b-tima/power_ice/README.md

# power_ice

Project files created for the course II2302 Sensor Based Systems @KTH.

## Project members:

* Morgan Adamsson
* Samuel Svensson
* Skander Ben Messaoud
* Robin Carlet
