b-tima/power_ice/presentation/presentation.pdf

### II2302 project :

# Ice detection sensor

Morgan Adamsson
Robin Carlet
Samuel Svensson
Skander Ben Messaoud

Sensor | What should the sensor detect ?
- Ice
- Water on the surface
- Dry surface

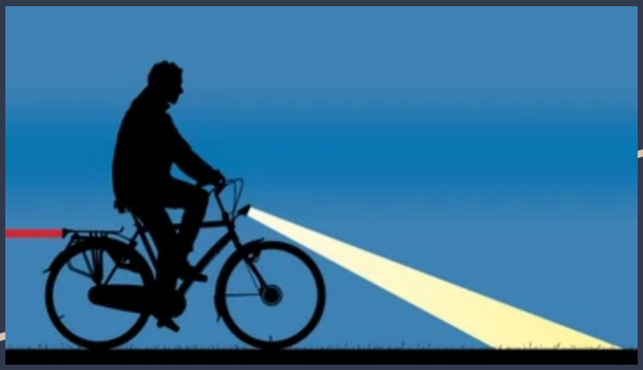
[picture p10: figure]

Applications of the sensor :

- Bicycle accessory
- Ice detection on roads
- Vibrating handles and flashing lights for warning

Implementation | ● Measurement of backscattered

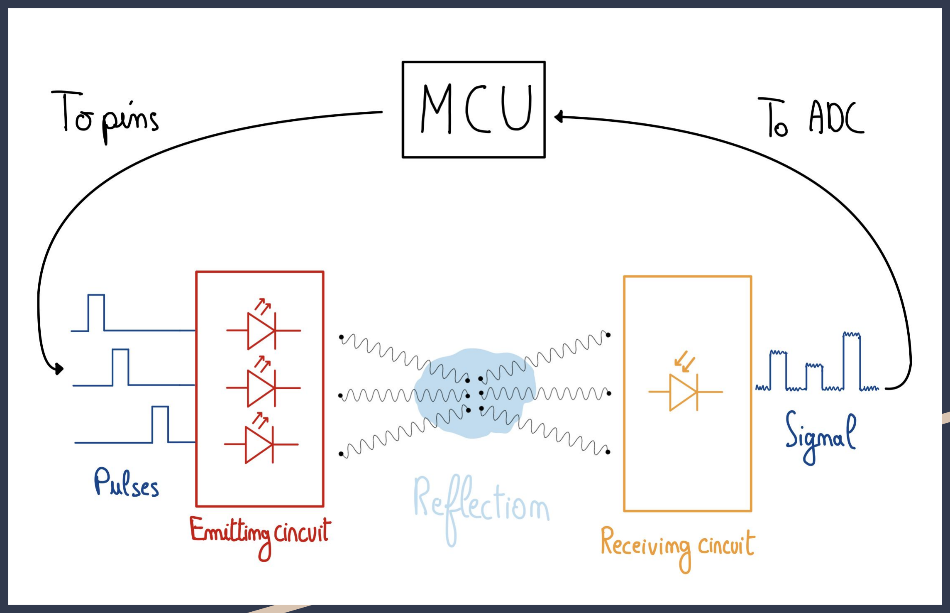
[picture p11: figure]

| power of IR reflections
- Three wavelengths are used
- 1300 nm
- 1450 nm
- 1550 nm
- InGaAs (Indium gallium arsenide) photodiode for detecting
reflections

https://opg.optica.org/view_article.cfm

# Emitting circuit

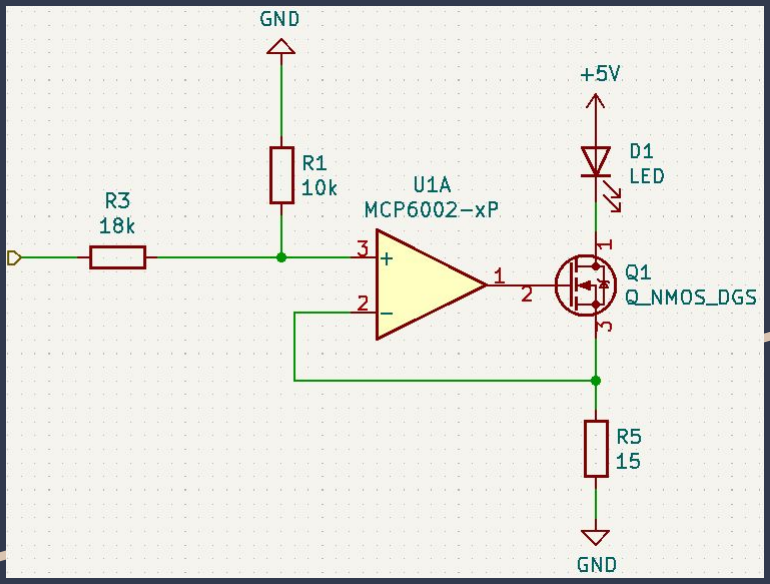
[picture p12: figure]

- Mosfet transistor sinking current from IR LED
- Turns on by voltage from MCU
- Stable and precise current

# Sensing circuit

- Transconductance amplifier to sense the photodiode

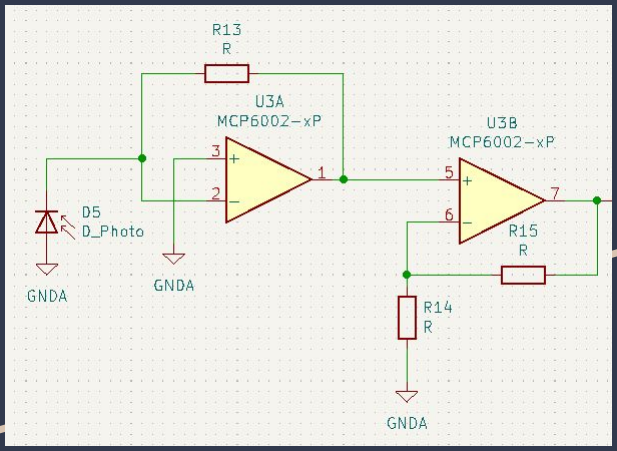
[picture p13: figure]

- Non-Inverting amplifier to increase gain.
- DC-offset is a problem.

Software | ● Pulse LEDs sequentially

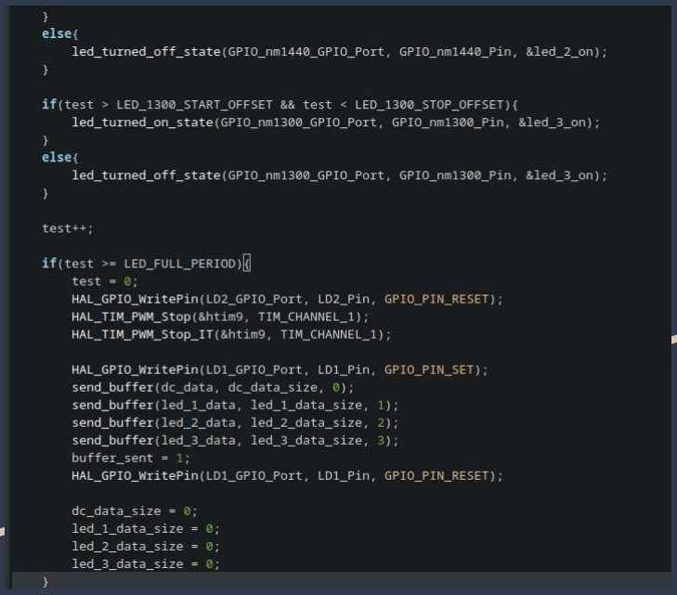
[picture p14: figure]

- Measure reflections with 12-bit ADC
- Store results in array
- Send array to computer at the end of sampling

# Design process

- Constructed circuit on
breadboards

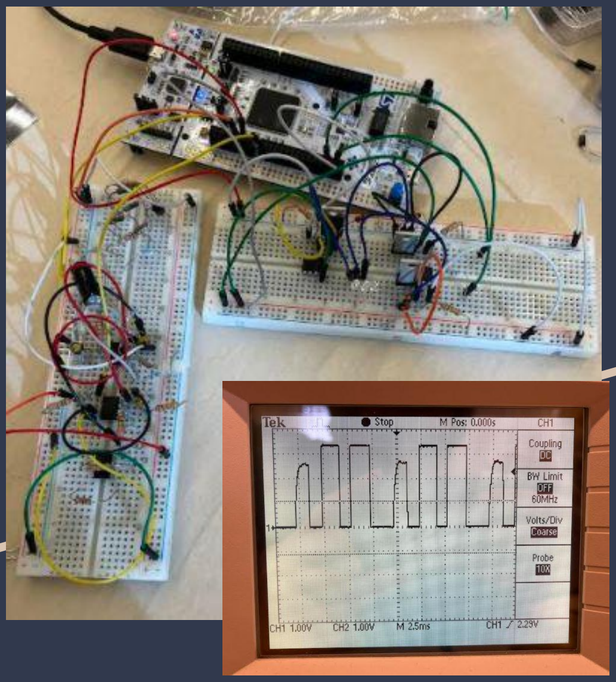
[picture p15: figure]

- LEDs and photodiode on separate boards
- Testing of received signal strength on oscilloscope

- Six LEDs (only three soldered)
- Two cascaded opamps are
unused.
- LEDs surround photodiode

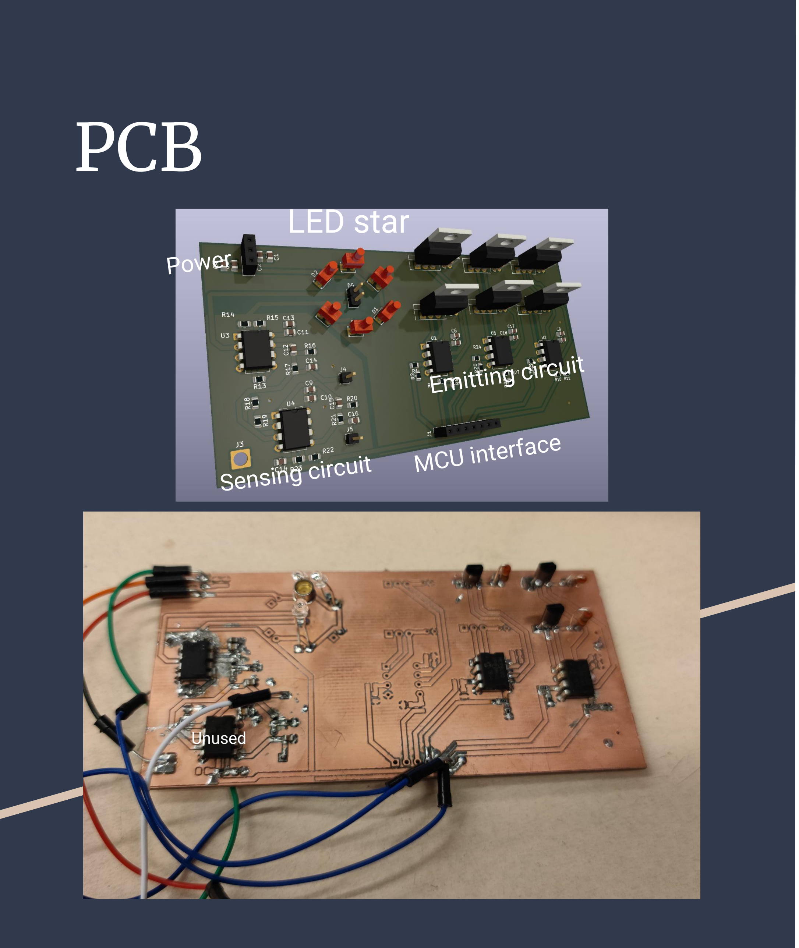
[picture p16: figure]
PCB; Power; Sensing circuit; Emitting circuit; LED star; MCU interface

- Connectors to MCU board Unused

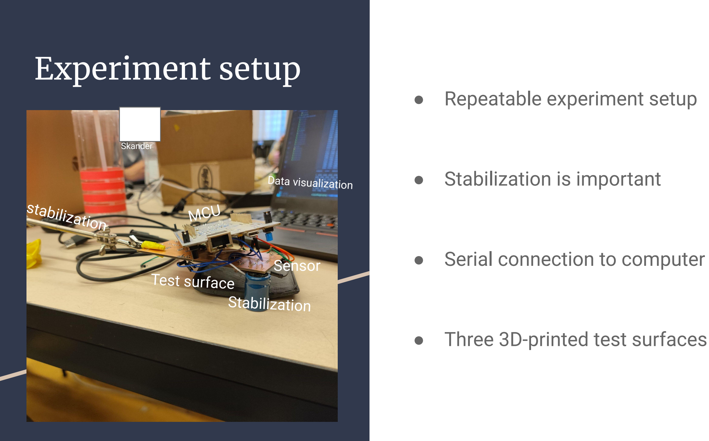
[picture p17: figure]
Experiment setup; ● Repeatable experiment setup; ● Stabilization is important; ● Serial connection to computer; ● Three 3D-printed test surfaces; stabilization; MCU; Sensor; Test surface Stabilization; Data visualization; Skander

# Data

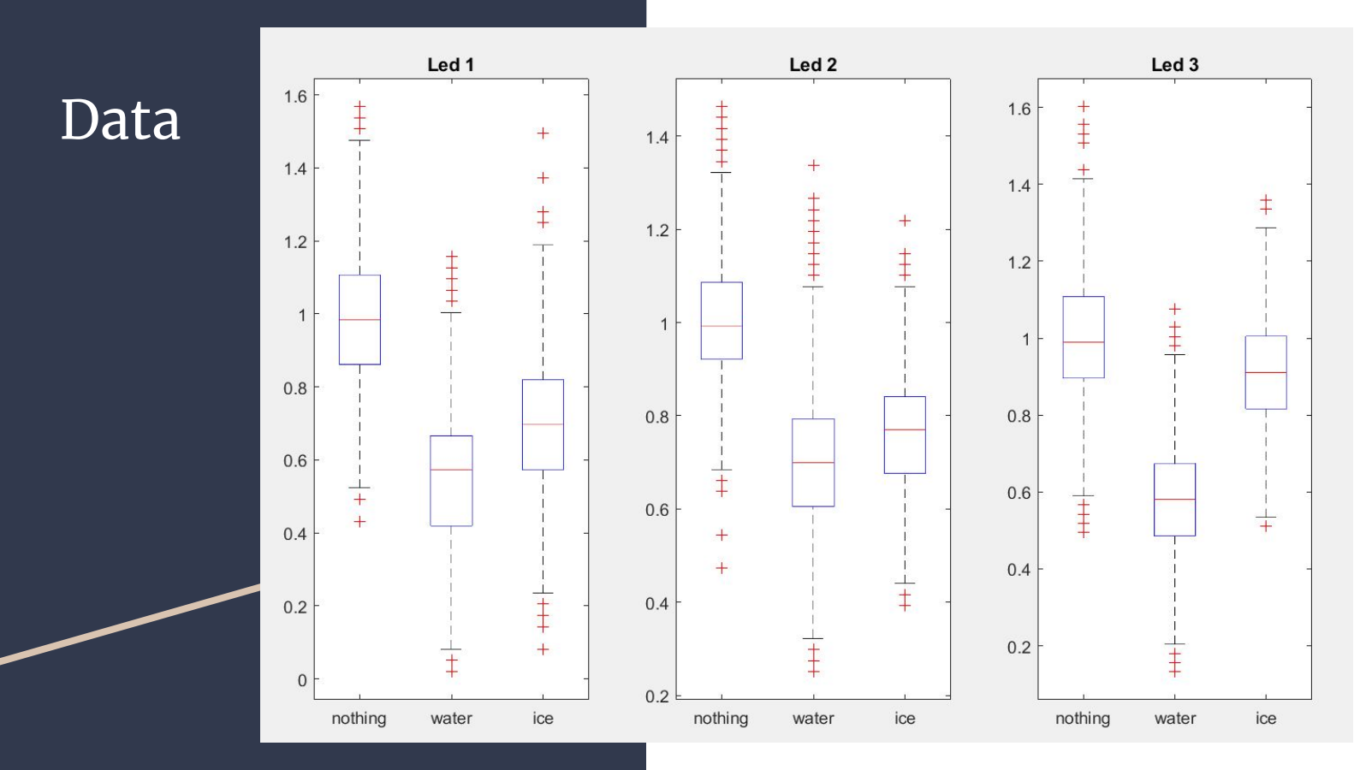
[picture p18: page 10]

# Data

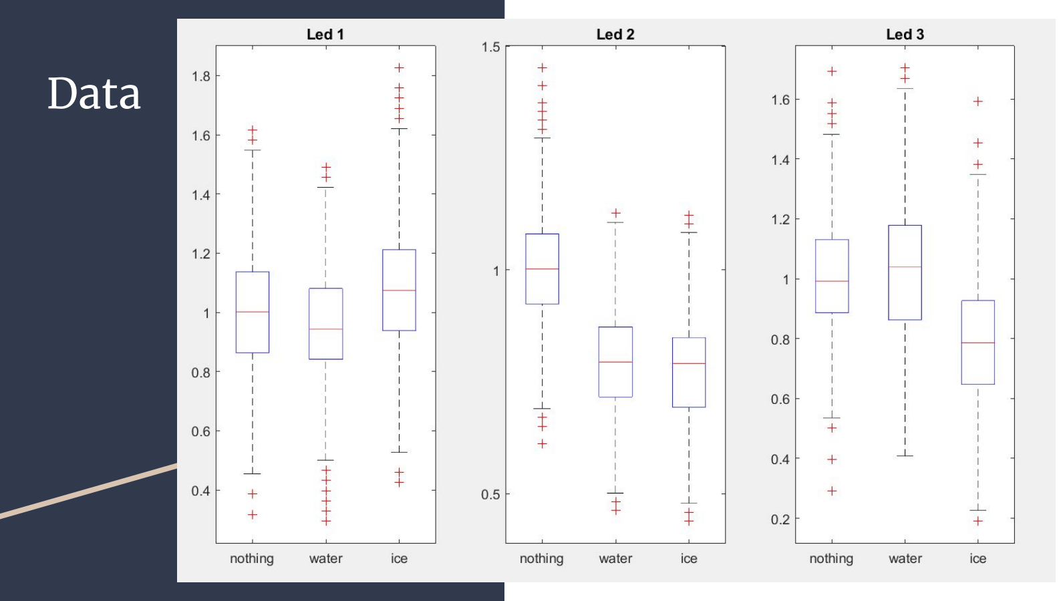
[picture p19: page 11]

# Data

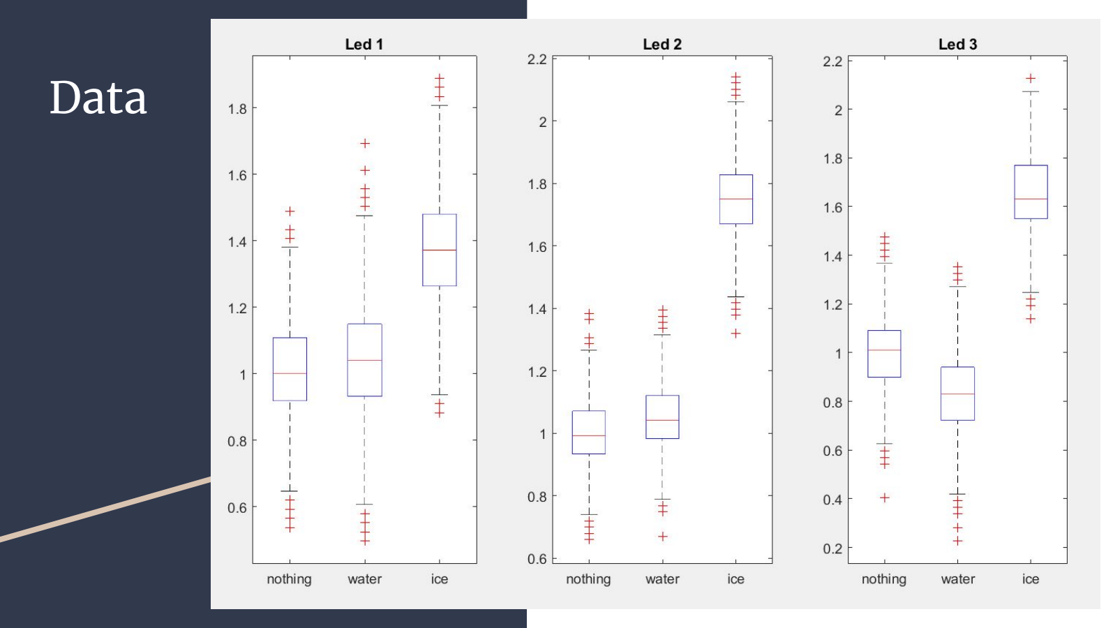
[picture p20: page 12]

# Areas of improvement

- More power and spread of power could improve performance
- Get sensing cascade to work (eliminate DC-offset)
- improvement of test environment
- we can still see differences between ice and the rest within each measurement

# Thanks for listening
