b-tima/power_ice/data_collection/matlab/box.png

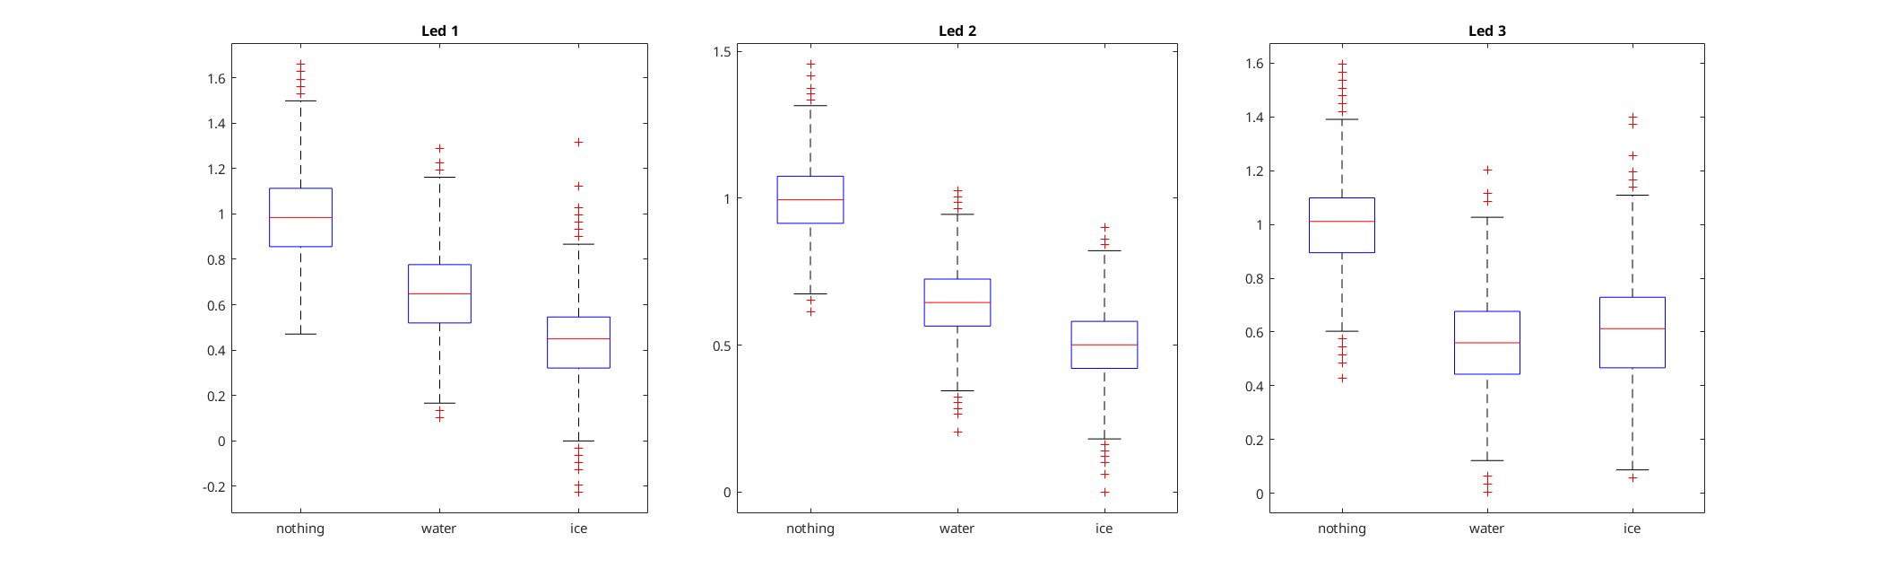
data_collection/matlab/box.png
