b-tima/power_ice/data_collection/matlab/box_4.png

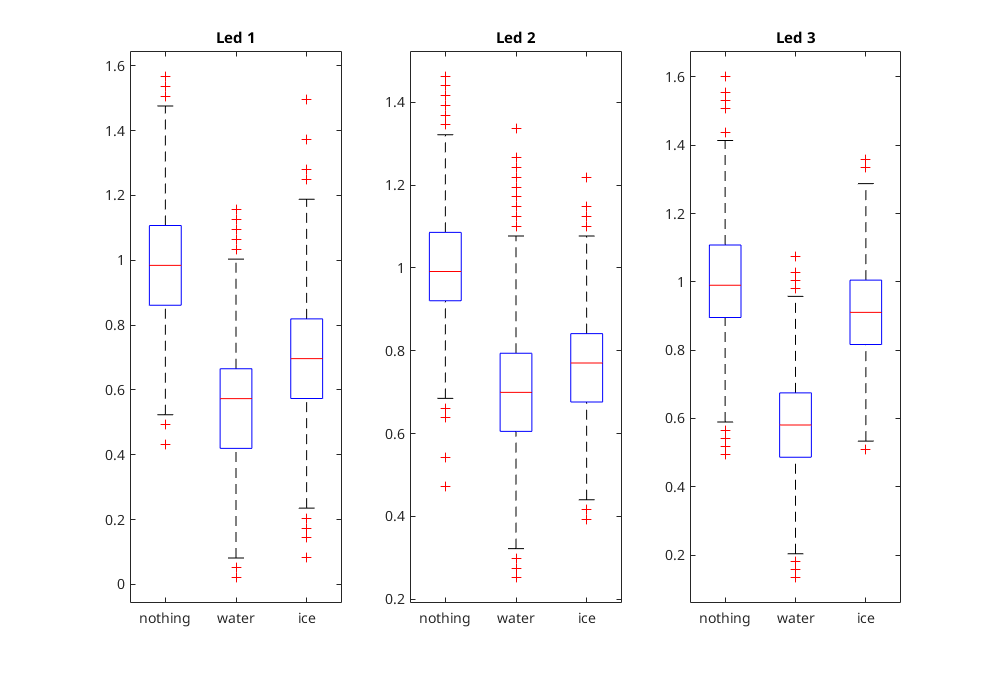
data_collection/matlab/box_4.png
