b-tima/power_ice/data_collection/matlab/box_5.png

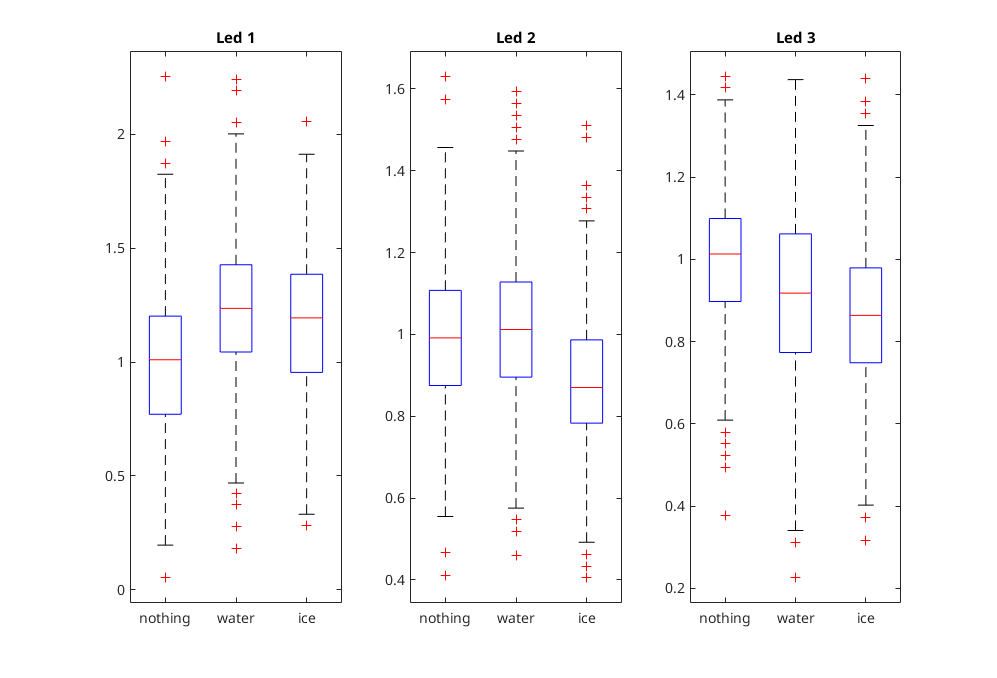
data_collection/matlab/box_5.png
