b-tima/power_ice/data_collection/matlab/normalized.png

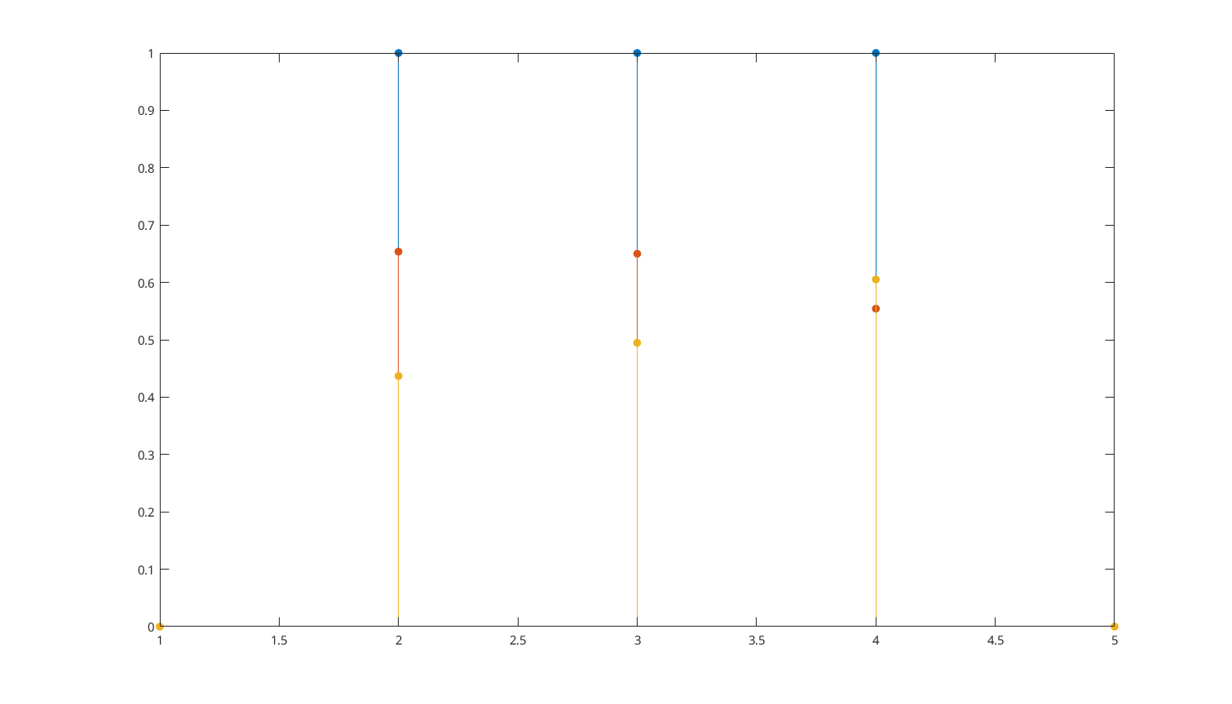
data_collection/matlab/normalized.png
