b-tima/power_ice/data_collection/matlab/samples.png

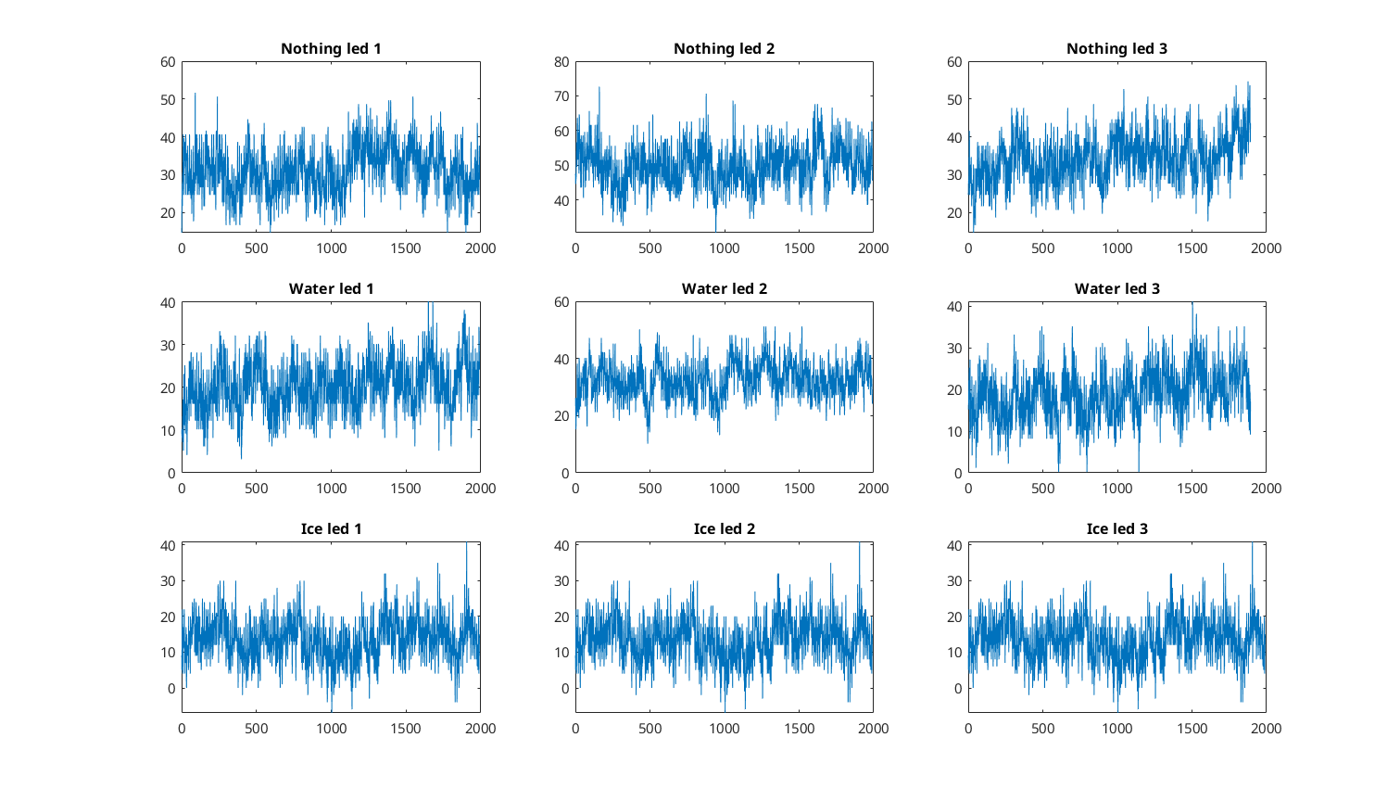
data_collection/matlab/samples.png
