b-tima/power_ice/data_collection/matlab/scatter.png

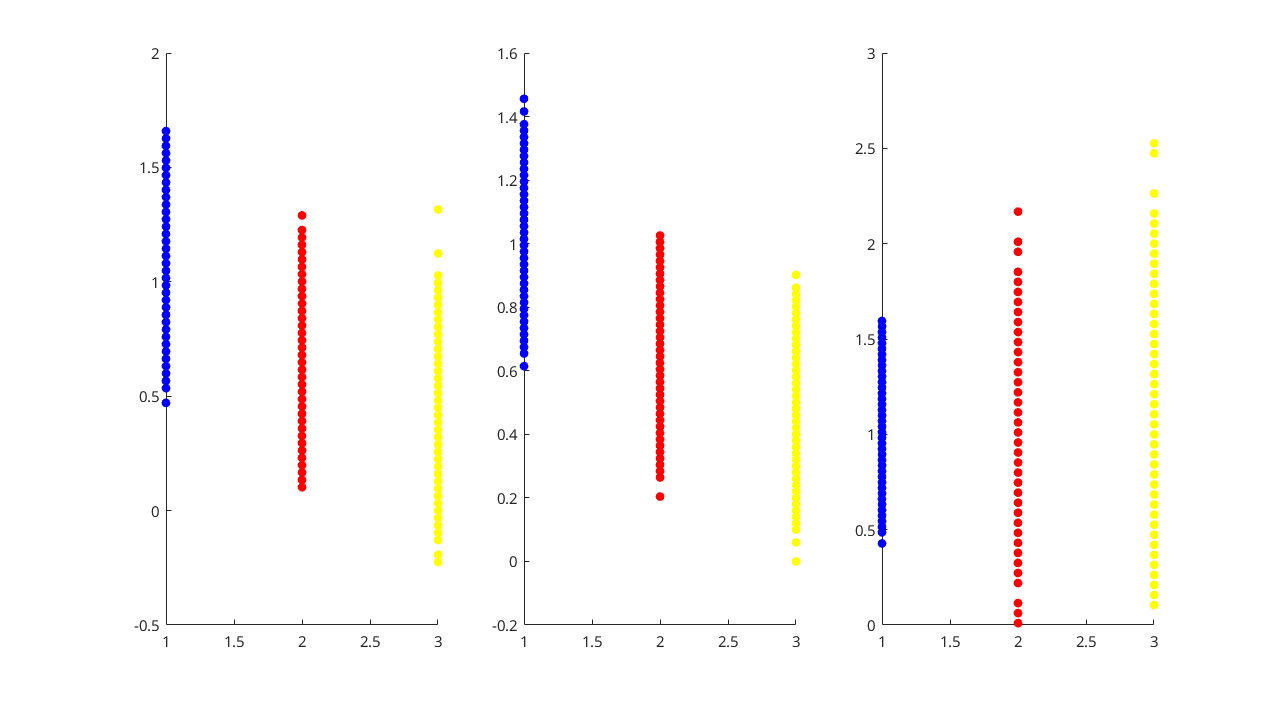
data_collection/matlab/scatter.png
