b-tima/power_ice/data_collection/matlab/swarm.png

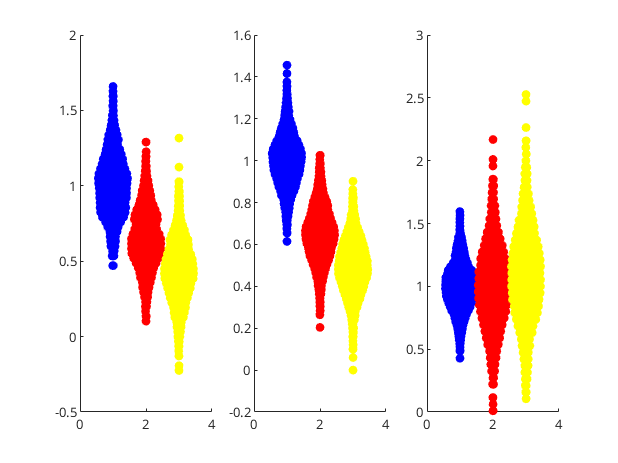
data_collection/matlab/swarm.png
