b-tima/power_ice/HW/power-ice.kicad_pcb

## KiCad design HW/power-ice.kicad_pcb (2022-03-12)

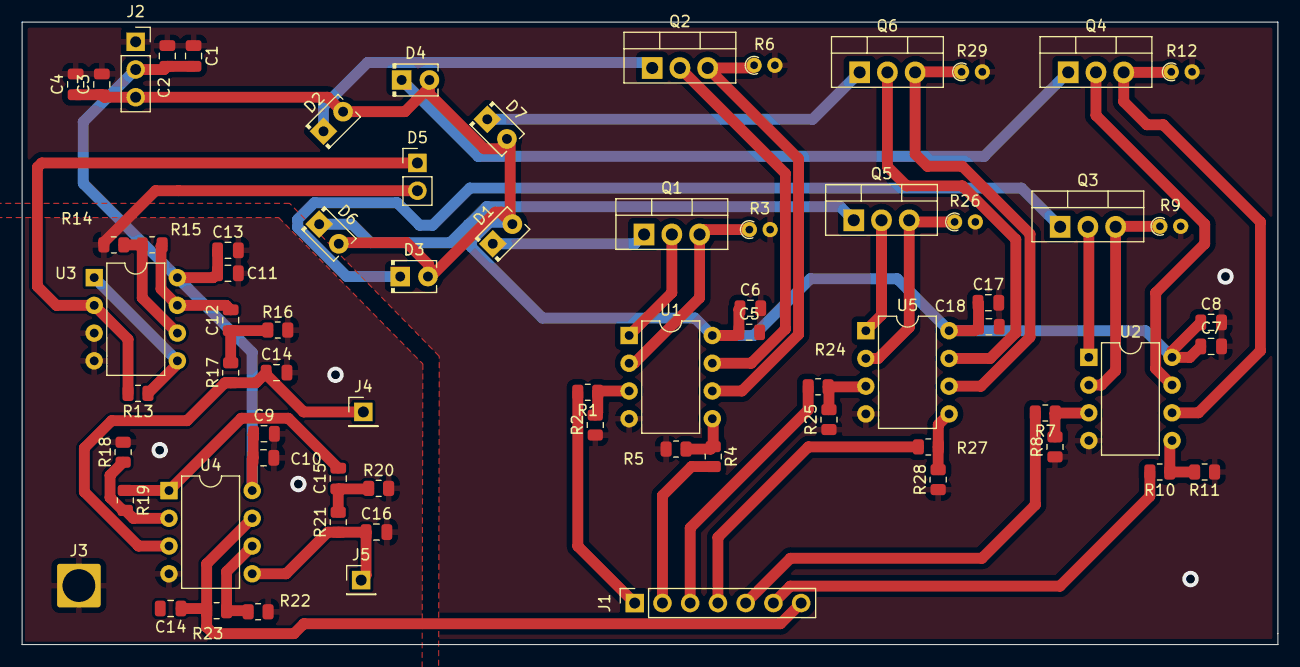
[picture p28: board power-ice.kicad_pcb from above]

Board: 2 copper layers, 115.0 x 57.0 mm, 71 parts (0 on the bottom side), 46 nets.

Parts:
C1, C2, C3, C4, C5, C6, C7, C8, C9, C10, C11, C12, C13, C14, C14#2, C15, C16, C17, C18: C; C_0805_2012Metric
D1, D2, D3, D4, D6, D7: LED; LED_D2.0mm_W4.0mm_H2.8mm_FlatTop
D5: D_Photo; PinHeader_1x02_P2.54mm_Vertical
J1: Conn_01x07_Female; PinSocket_1x07_P2.54mm_Vertical
J2: Conn_01x03_Female; PinSocket_1x03_P2.54mm_Vertical
J3: Conn_01x01_Female; SolderWire-2.5sqmm_1x01_D2.4mm_OD3.6mm
J4, J5: Conn_01x01_Female; PinHeader_1x01_P2.54mm_Vertical
Q1, Q2, Q3, Q4, Q5, Q6: Q_NMOS_DGS; TO-220-3_Vertical
R1, R4, R7, R10, R24, R27: 18k; R_0805_2012Metric
R2, R5, R8, R11, R25, R28: 10k; R_0805_2012Metric
R3, R6, R9, R12, R26, R29: 15; R_Axial_DIN0204_L3.6mm_D1.6mm_P1.90mm_Vertical
R13, R14, R15, R16, R17, R18, R19, R20, R21, R22, R23: R; R_0805_2012Metric
U1, U2, U3, U4, U5: MCP6002-xP; DIP-8_W7.62mm

Connections:
+3V3: C1.2, C2.1, C9.1, C10.1, C11.1, C13.1, J2.2, U3.8 (V+), U4.8 (V+)
+5V: C3.1, C4.1, C5.1, C6.1, C7.1, C8.1, C17.1, C18.1, D1.2 (A), D2.2 (A), D3.2 (A), D4.2 (A), D6.2 (A), D7.2 (A), J2.3
/IR_LED/InputLedAblock: J1.1, R1.2
/IR_LED/InputLedBblock: J1.2, R4.2
/Sheet6239F98A/OutputPDCircuit: C14#2.1, J1.7, R23.1, U4.7
/sheet6238A8B8/InputLedAblock: J1.3, R24.2
/sheet6238A8B8/InputLedBblock: J1.4, R27.2
/sheet62353F20/InputLedAblock: J1.5, R7.2
/sheet62353F20/InputLedBblock: J1.6, R10.2
GND: C1.1, C2.2, C3.2, C4.2, C5.2, C6.2, C7.2, C8.2, C17.2, C18.2, J2.1, R2.1, R3.2, R5.1, R6.2, R8.1, R9.2, R11.1, R12.2, R25.1, R26.2, R28.1, R29.2, U1.4 (V-), U2.4 (V-), U5.4 (V-)
GNDA: C9.2, C10.2, C11.2, C13.2, C14.2, C16.2, D5.2 (A), J3.1, R14.2, R16.2, R18.2, R20.2, R22.2, U3.3 (+), U3.4 (V-), U4.4 (V-)
unnamed: C12.1, R16.1, R17.2
unnamed: C12.2, R15.1, U3.7
unnamed: C14.1, J4.1, R17.1, U4.3 (+)
unnamed: C15.1, R20.1, R21.2
unnamed: C15.2, R19.1, U4.1
unnamed: C16.1, J5.1, R21.1, U4.5 (+)
unnamed: D1.1 (K), Q1.1 (D)
unnamed: D2.1 (K), Q2.1 (D)
unnamed: D3.1 (K), Q3.1 (D)
unnamed: D4.1 (K), Q4.1 (D)
unnamed: D5.1 (K), R13.2, U3.2 (-)
unnamed: D6.1 (K), Q5.1 (D)
unnamed: D7.1 (K), Q6.1 (D)
unnamed: Q1.2 (G), U1.1
unnamed: Q1.3 (S), R3.1, U1.2 (-)
unnamed: Q2.2 (G), U1.7
unnamed: Q2.3 (S), R6.1, U1.6 (-)
unnamed: Q3.2 (G), U2.1
unnamed: Q3.3 (S), R9.1, U2.2 (-)
unnamed: Q4.2 (G), U2.7
unnamed: Q4.3 (S), R12.1, U2.6 (-)
unnamed: Q5.2 (G), U5.1
unnamed: Q5.3 (S), R26.1, U5.2 (-)
unnamed: Q6.2 (G), U5.7
unnamed: Q6.3 (S), R29.1, U5.6 (-)
unnamed: R1.1, R2.2, U1.3 (+)
unnamed: R4.1, R5.2, U1.5 (+)
unnamed: R7.1, R8.2, U2.3 (+)
unnamed: R10.1, R11.2, U2.5 (+)
unnamed: R13.1, U3.1, U3.5 (+)
unnamed: R14.1, R15.2, U3.6 (-)
unnamed: R18.1, R19.2, U4.2 (-)
unnamed: R22.1, R23.2, U4.6 (-)
unnamed: R24.1, R25.2, U5.3 (+)
unnamed: R27.1, R28.2, U5.5 (+)
