b-tima/power_ice/EMB_SW/Power ice/Core/Src/main.c

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
/* Includes ------------------------------------------------------------------*/
#include "main.h"
#include "usb_device.h"

/* USER CODE BEGIN Includes */

#include <stdint.h>
#include <string.h>

#include "usbd_cdc_if.h"

/* USER CODE END Includes */

/* USER CODE BEGIN PD */

#define LED_FULL_PERIOD 		15000

#define DC_START_OFFSET			0
#define DC_STOP_OFFSET			2000

#define LED_1550_START_OFFSET 	3000
#define LED_1550_STOP_OFFSET 	5000

#define LED_1440_START_OFFSET 	6000
#define LED_1440_STOP_OFFSET	8000

#define LED_1300_START_OFFSET	9000
#define LED_1300_STOP_OFFSET	11000

#define IR_SAMPLE_BUFFER_SIZE 2000

/* USER CODE END PD */

ADC_HandleTypeDef hadc1;

TIM_HandleTypeDef htim9;

UART_HandleTypeDef huart3;

/* USER CODE BEGIN PV */

uint16_t ir_1550_samples[IR_SAMPLE_BUFFER_SIZE];
uint16_t ir_1440_samples[IR_SAMPLE_BUFFER_SIZE];
uint16_t ir_1300_samples[IR_SAMPLE_BUFFER_SIZE];

/* USER CODE END PV */

void SystemClock_Config(void);
static void MX_GPIO_Init(void);
static void MX_USART3_UART_Init(void);
static void MX_TIM9_Init(void);
static void MX_ADC1_Init(void);
/* USER CODE BEGIN 0 */

int gaming = 0;

uint32_t timer = 0;

/* USER CODE END 0 */

/**
  * @brief  The application entry point.
  * @retval int
  */
int main(void)
{
  /* MCU Configuration--------------------------------------------------------*/

  /* Reset of all peripherals, Initializes the Flash interface and the Systick. */
  HAL_Init();

  /* Configure the system clock */
  SystemClock_Config();

  /* Initialize all configured peripherals */
  MX_GPIO_Init();
  MX_USART3_UART_Init();
  MX_TIM9_Init();
  MX_ADC1_Init();
  MX_USB_DEVICE_Init();
  /* USER CODE BEGIN 2 */

  HAL_TIM_Base_Start_IT(&htim9);

  HAL_ADC_Start_IT(&hadc1);

  uint8_t my_string[30];
  sprintf((char*) my_string, "hej");

  /* USER CODE END 2 */

  /* Infinite loop */
  /* USER CODE BEGIN WHILE */
  while (1)
  {
	  //HAL_GPIO_WritePin(GPIO_nm1550_GPIO_Port, GPIO_nm1550_Pin, GPIO_PIN_SET);
	  //HAL_GPIO_WritePin(GPIO_nm1300_GPIO_Port, GPIO_nm1300_Pin, GPIO_PIN_SET);
	  //HAL_GPIO_WritePin(GPIO_nm1440_GPIO_Port, GPIO_nm1440_Pin, GPIO_PIN_SET);
	  //HAL_GPIO_TogglePin(LD2_GPIO_Port, LD2_Pin);

	  //HAL_Delay(100);
	  //HAL_GPIO_WritePin(samus_probe_GPIO_Port, samus_probe_Pin, GPIO_PIN_SET);
    /* USER CODE END WHILE */

    /* USER CODE BEGIN 3 */
  }
  /* USER CODE END 3 */
}

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
/* USER CODE BEGIN 4 */

char* start = "--LED";
char* stop = "--stop--";
char* start_pattern[100];
char* sequence_complete_pattern = "--compl--";

int dc_on = 0;
int led_1_on = 0;
int led_2_on = 0;
int led_3_on = 0;

uint32_t dc_data_size = 0;
uint32_t led_1_data_size = 0;
uint32_t led_2_data_size = 0;
uint32_t led_3_data_size = 0;

uint16_t dc_data[IR_SAMPLE_BUFFER_SIZE];
uint16_t led_1_data[IR_SAMPLE_BUFFER_SIZE];
uint16_t led_2_data[IR_SAMPLE_BUFFER_SIZE];
uint16_t led_3_data[IR_SAMPLE_BUFFER_SIZE];

int buffer_sent = 0;

uint8_t data[100];

void send_buffer(uint16_t* buffer, size_t size, uint8_t led){
	sprintf(start_pattern, "%s%d", start, led);
	for(size_t i = 0; i < size; i++){
		sprintf(data, "LED%d: %d\n", led, buffer[i]);
		HAL_UART_Transmit(&huart3, data, strlen(data), 10);
	}
}

void led_turned_on_state(GPIO_TypeDef* port, uint16_t pin, int *state){
	HAL_ADC_Start_IT(&hadc1);
	*state = 1;
	HAL_GPIO_WritePin(port, pin, GPIO_PIN_SET);
	buffer_sent = 0;
}

void led_turned_off_state(GPIO_TypeDef* port, uint16_t pin, int *state){
	//HAL_ADC_Stop_IT(&hadc1);
	*state = 0;
	HAL_GPIO_WritePin(port, pin, GPIO_PIN_RESET);
}

int test = 0;

void HAL_TIM_PeriodElapsedCallback(TIM_HandleTypeDef *htim){
	if(test > DC_START_OFFSET && test < DC_STOP_OFFSET){
		led_turned_on_state(LD3_GPIO_Port, LD3_Pin, &dc_on);
	}
	else{
		led_turned_off_state(LD3_GPIO_Port, LD3_Pin, &dc_on);
	}

	if(test > LED_1550_START_OFFSET && test < LED_1550_STOP_OFFSET){
		led_turned_on_state(GPIO_nm1550_GPIO_Port, GPIO_nm1550_Pin, &led_1_on);
	}
	else{
		led_turned_off_state(GPIO_nm1550_GPIO_Port, GPIO_nm1550_Pin, &led_1_on);
	}

	if(test > LED_1440_START_OFFSET && test < LED_1440_STOP_OFFSET){
		led_turned_on_state(GPIO_nm1440_GPIO_Port, GPIO_nm1440_Pin, &led_2_on);
	}
	else{
		led_turned_off_state(GPIO_nm1440_GPIO_Port, GPIO_nm1440_Pin, &led_2_on);
	}

	if(test > LED_1300_START_OFFSET && test < LED_1300_STOP_OFFSET){
		led_turned_on_state(GPIO_nm1300_GPIO_Port, GPIO_nm1300_Pin, &led_3_on);
	}
	else{
		led_turned_off_state(GPIO_nm1300_GPIO_Port, GPIO_nm1300_Pin, &led_3_on);
	}

	test++;

	if(test >= LED_FULL_PERIOD){
		test = 0;
		HAL_GPIO_WritePin(LD2_GPIO_Port, LD2_Pin, GPIO_PIN_RESET);
		HAL_TIM_PWM_Stop(&htim9, TIM_CHANNEL_1);
		HAL_TIM_PWM_Stop_IT(&htim9, TIM_CHANNEL_1);

		HAL_GPIO_WritePin(LD1_GPIO_Port, LD1_Pin, GPIO_PIN_SET);
		send_buffer(dc_data, dc_data_size, 0);
		send_buffer(led_1_data, led_1_data_size, 1);
		send_buffer(led_2_data, led_2_data_size, 2);
		send_buffer(led_3_data, led_3_data_size, 3);
		buffer_sent = 1;
		HAL_GPIO_WritePin(LD1_GPIO_Port, LD1_Pin, GPIO_PIN_RESET);

		dc_data_size = 0;
		led_1_data_size = 0;
		led_2_data_size = 0;
		led_3_data_size = 0;
	}
}

int adc_test = 0;

void HAL_ADC_ConvCpltCallback(ADC_HandleTypeDef *hadc){
	uint16_t value = HAL_ADC_GetValue(&hadc1);
	adc_test = value;
	if(dc_on){
		if(dc_data_size < IR_SAMPLE_BUFFER_SIZE){
			dc_data[dc_data_size++] = value;
		}
	}
	else if(led_1_on){
		if(led_1_data_size < IR_SAMPLE_BUFFER_SIZE){
			led_1_data[led_1_data_size++] = value;
		}
	}
	else if(led_2_on){
		if(led_2_data_size < IR_SAMPLE_BUFFER_SIZE){
			led_2_data[led_2_data_size++] = value;
		}
	}
	else if(led_3_on){
		if(led_3_data_size < IR_SAMPLE_BUFFER_SIZE){
			led_3_data[led_3_data_size++] = value;
		}
	}
}

void HAL_GPIO_EXTI_Callback(uint16_t GPIO_Pin){
	HAL_GPIO_WritePin(LD2_GPIO_Port, LD2_Pin, GPIO_PIN_SET);
	HAL_TIM_PWM_Start_IT(&htim9, TIM_CHANNEL_1);
	HAL_TIM_PWM_Start(&htim9, TIM_CHANNEL_1);

}

/* USER CODE END 4 */
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
