b-tima/power_ice/(commit log)

2022-03-12 added hw files
    [IR_LED.kicad_sch, IR_LED.sch, PhotodiodeBlock.kicad_sch, PhotodiodeBlock.sch, cascade_filter.sch, jumperopamp.kicad_sch, jumperopamp.sch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]
2022-03-12 added software
    [ice_4.csv, ice_5.csv, nothing_4.csv, nothing_5.csv, water_4.csv, water_5.csv]
2022-03-12 added data and matlab files
    [ice.csv, ice_2.csv, ice_3.csv, ice_4.csv, ice_5.csv, nothing.csv, nothing_2.csv, nothing_3.csv]
2022-03-14 added data
    [ice_6.csv, ice_7.csv, nothing_6.csv, nothing_7.csv, water_6.csv, water_7.csv]
